Szum123321/weit_generator_v1/code/README.MD

Pliki kodu źródłowego znajdują się w folderze ./src. Plik konfiguracyjny w folderze ./include. W celu skompilowania pobierz i zainstaluj środowisko PlatformIO
