Szum123321/weit_generator_v1/docs/raport_techniczny.pdf

## Generator sygnału 1 kHz

Raport Techniczny

Szymon Januszek, szymon_j@tutanota.com

Kwiecień 2023

Streszczenie

Głównym celem poniższej konstrukcji jest otrzymanie sygnału możliwie najwyższej jakości, zdefiniowanych w założeniach konkursowych, tzn. dokładność częstotliwości, stopień zniekształceń harmonicznych oraz dokładność amplitudy sygnału.

## Spis treści

1 Bezpośrednia synteza cyfrowa | 3
2 Kształtowanie | 4
3 Kontrola Amplitudy | 5
4 Oprogramowanie | 7
5 Eksperymenty | 9

## 1 Bezpośrednia synteza cyfrowa

Aby wygenerować maksymalnie stabilny i dokładny względem częstotliwości sygnał, zdecydowałem się na wykorzystanie techniki Bezpośredniej Syntezy Cyfrowej, gdzie mikroprocesor wraz z układem Przetwornika Cyfrowo-Analogowego (DAC) generuje sygnał zbliżony do sygnału oczekiwanego. Umożliwia to zastosowanie wysokiej jakości generatora kwarcowego, jako głównego źródła odniesienia, o precyzji rzędu 50ppm¹
, w całym zakresie temperatur. Oznacza to, iż częstotliwość uzyskanego sygnału nie będzie odbiegać o więcej niż ±50 mHz od wartości oczekiwanej.

### 1.1 Mikrokontroler

Jako główny mikrokontroler wybrany został układ AVR32DA28[2] należący do rodziny 8-bitowych układów AVR. W porównaniu ze starszymi generacjami, producent dopuszcza pracę układu przy częstotliwościach przekraczających 8 MHz z napięciem 3 V. Jednocześnie dokonana została unifikacja modelu pamięci, co okaże być się przydatne przy pisaniu oprogramowania(4).

### 1.2 Przetwornik Cyfrowo-Analogowy

Do implementacji przetwornika zrealizowany został układ drabinki R-2R (Rys.1). Umożliwiając łatwą zmianę wartości liczbowej, przedstawionej jako liczba binarna na pinach mikrokontrolera, na ułamek napięcia zasilania.

2R

a0

R

an−1

2R | 2R

a1

R

an−2

2R

R

2R

a2

2R

Vout

Rysunek 1: Schemat drabiny R-2R [1]

Napięcie na węźle wyjściowym przetwornika można opisać w następujący sposób:

Vout = Vref ×

a0 × 2

0 + a1 × 2

1 + a2 × 2

2 + ... + aN−1 × 2

N−1
2

N
Jak widać, przy N = 8, przetwornik ten pozwala na uzyskanie 256 różnych wartości. Dla Vref = 3 V, oznacza to, iż różnica pomiędzy dwoma dowolnymi stopniami wynosi ok. 11.72 mV.
Co ciekawe, okazuje się, iż impedancja wyjściowa takiego układu jest stała dla każdego poziomu 2

1Części na milion
2Wynika to z Twierdzenie Thévenina, zakładającego zerową impedancję źródła oraz mikrokontrolera. W rzeczywistości ich wartości są znacznie mniejsze od wartości R.

Aby zachować użyteczność najniższych bitów, precyzja wykorzystanych rezystorów musi być lepsza niż 1
2N × 100% ≈ 0.3 %. Na szczęście, w sprzedaży dostępne są rezystory przeznaczone do montażu powierzchniowego o precyzji 0.1 %.

### 1.3 Analiza sygnału wyjściowego

Sygnał generowany w ten sposób nie opowiada jednak perfekcyjnej sinusoidzie (Rys. 2). Obecne jest tzw. zniekształcenie kwantyzacji, wynikające z faktu, iż sygnał złożony jest z serii dyskretnych wartości. Jednak jeśli dokładnie przyjrzymy się różnicy pomiędzy naszym sygnałem a idealnej sinusoidzie, to okaże się, że amplituda takiego sygnału jest nie wielka (∆V ←

Vref
2N ), a także składa się on z częstotliwości wielokrotnie większych niż częstotliwość fundamentalna generowanego sygnału.

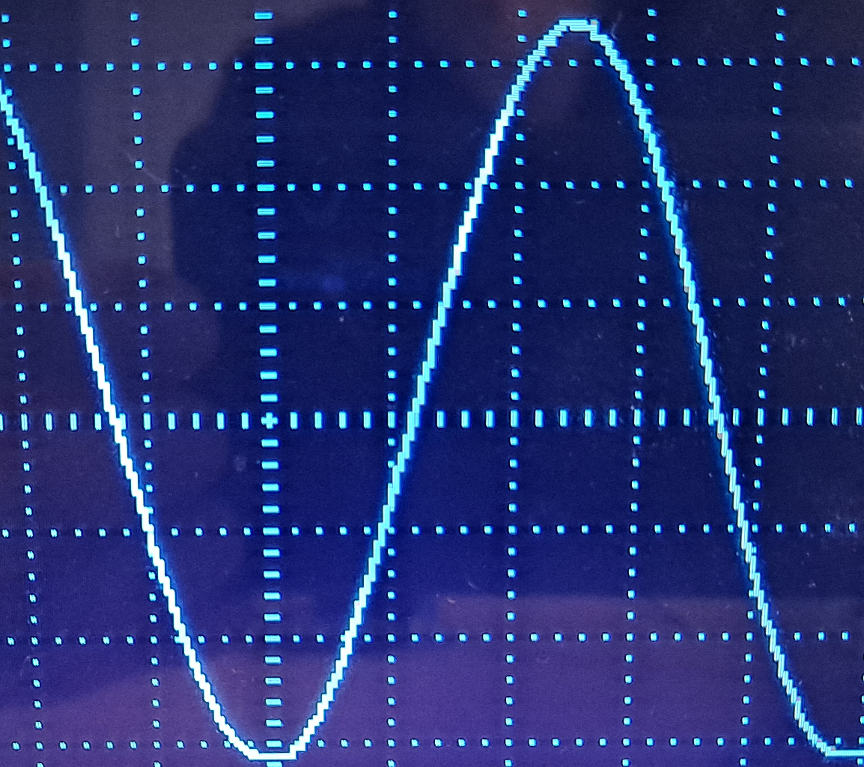
[picture p4: figure]

Rysunek 2: Przebieg sinusoidy generowanej przy pomocy przetwornika R-2R.

Możemy uznać, iż dobrym przybliżeniem takiego sygnału będzie suma sinusoidy o amplitudzie równej połowie napięcia zasilania Vref i o częstotliwości f0 oraz sygnału prostokątnego o częstotliwości f0×Nsmpl i amplitudzie 0.5×

Vref
2N , gdzie Nsmpl oznacza
ilość dyskretnych zmian napięcia w czasie jednego okresu.
Widzimy więc że że częstotliwość już częstotliwość drugiej składowej jest Nsmpl -krotnie większa, a jej amplituda 2

N−2π-krotnie mniejsza w porównaniu ze składową fundamentalną. Oznacza to, iż przy zastosowaniu filtru dolnoprzepustowego niskiego stopnia, możliwe jest efektywne usunięcie składowych wyższej częstotliwości.

## 2 Kształtowanie

Mimo wszystko należy usunąć składowe wyższej częstotliwości. Funkcje tą realizuje kondensator C2 (Rys. 3).
Dodatkowo, rzeczywiste wzmacniacze operacyjne nie są wstanie generować sygnałów bardzo bliskich < 300 mV szyn zasilania. Tłumienia tego dokonują C1, R1, R2, zachowując wartość środkową na poziomie 1.5 V

R1 100k

R2 100k

GND

5+
6-

7

U1B

+3V0
C1 10n

GND

C2 10n

IN | OUT

GND

+3V0

R1 100k

GND

R2 100k

Rysunek 3: Schemat filtru

## 3 Kontrola Amplitudy

Ostatnią zmienną którą należy rozpatrzyć jest amplituda sygnału wyjściowego. Na tym etapie amplituda sygnału jest większa od oczekiwanej wartości 0.5 V. Potrzebna jest więc metoda dokładnego tłumienia, nie wprowadzająca dodatkowych zniekształceń i zakłócenia.
Rozwiązanie oparte o nawet precyzyjny potencjometr pozostaje jednak wrażliwe na takie zmienne jak napięcie zasilania, czy też dryft parametrów elementów związany ze zmianą temperatury.
Tak więc, niezbędny jest układ aktywnie korygujący amplitudę sygnału. Cyfrowa implementacja takiego rozwiązania nie wchodzi w gre, ponieważ przetwornik DAC nie posiada wystarczającej głębokości bitowej. Stąd też, proponuję rozwiązanie w pełni analogowe.
Przy użyciu wzmacniaczy operacyjnych możemy uzyskać pętle sprzężenia zwrotnego, korygującą amplitude sygnału względem stałego napięcia odniesienia. Do realizacji tego rozwiązania potrzebujemy następujących elementów.

### 3.1 Pomiar amplitudy

Konieczny jest pomiar amplitudy sygnału wyjściowego. To tego celu służy tzw. Detektor szczytowy (Rys. 4).

R3 1M

R2 100

GND GND

C1 10n

R1 1M | D1 12+ | 1N6263

13-

14

U1D MCP6004

OUT IN

Peak detector

C1 10n

GND GND

R3 1M

Rysunek 4: Przykładowy schemat połówkowego detektora szczytowego

### 3.2 Element sprzęgający

Wymagany jest układ umożliwiający tłumienie sygnału zmiennego względem sygnału sterującego:

Vwyj ∝

Vwej

Vster

(1)

Fizyczna implementacja takiego układu okazuje się być niebanalna. Możliwy jest układ realizujący operacje mnożenia wartości sygnałów. Jego realizacja jednak jest wysoce złożona i wymaga relatywnie dużo części, ponieważ w jego skład wchodzą układy wyznaczające logarytm naturalny obu wartości, dodające te wartości do siebie, a na koniec wyznaczające funkcje wykładniczą e

x
tej sumy.
Alternatywna metoda wykorzystuje element zmieniający swój opór elektryczny względem jakiegoś innego czynnika. Przykładem historycznej realizacji takiego układu jest zastosowanie niewielkiej łapmy żarowej, której opór włókna jest wprost proporcjonalny do jego temperatury.
Istnieje jednak znacznie prostsze i wydajniejsze rozwiązanie.
Popularnym elementem o zmiennym oporze jest fotorezystor. W przeciwieństwie do innych elementów światłoczułych, przy stałym natężeniu światła, zachowuje się on jak faktyczny rezystor, tzn. prąd przepływający jest wprost proporcjonalny do napięcia i odwrotnie do jego oporu I ∝

V
Rφ
Tak więc, jeśli zamknie się fotorezystor w obudowie światłoszczelnej wraz z diodą LED, uzyskamy układ o zmiennym oporze elektrycznym, kontrolowany przez prąd diody³

R ∝

1

ILed

(2)

Umożliwia to łatwą implementacje układu sprzężenia (Eq. 1).
Co prawda powyższy model ignoruje fakt, iż tak na prawdę opór fotorezystora zależny jest wykładniczo od natężenia padającego światła R =
1
φ

A
. Nie stanowi jednak to dużego problemu ponieważ układ ten znajduje się w pętli sprzężenia zwrotnego.

R ∝

1

(ILed)

A

(3)

### 3.3 Źródło odniesienia

W tym momęcie potrzebne jest jedynie stabilne oraz dostrajalne źródło napięcia odniesienia. Do tego celu z zupełności wystarczy układ LM4041 wraz z precyzyjnym potencjometrem.

### 3.4 Dostrajanie

Szczególnie trudnym okazało się zapewnienie stabilnej pracy układu. Wartości elementów w pętli kompensacji zostały w większości dobrane empirycznie. Konieczne było zastosowanie dużej pojemności kondensatorów elektrolitycznych, ze względu na duży czas propagacji sygnału błędu przez tłumik, filtr oraz detektor.

3Zakładam φ ∝ I

## 4 Oprogramowanie

Czas przejść do opisu kodu źródłowego. W pliku sine_tab.cpp znajduje się definicja tabeli funkcji sinus. Składa się ona z 1024 próbek, a wartość i-tej próbki zdefiniowana jest w następujący sposób:

f(i) = (2N − 1) + $
(2N − 1) × sin

2π × i

Nsmpl !' | (4)

f(i) = 128 +

127 × sin

2π × i
1024 | (5)

Każda próbka jest 8-bitową liczbą całkowitą z zakresu ∈ {1 . . . 255}, jednocześnie tabela przedstawia cały jeden okres funkcji sinus, poza wartością sin(2π). Następną próbkę stanowi wartość sin(0). Dzięki temu reprodukowany sygnał nie zawiera przeskoku co cały okres.
Zadaniem oprogramowania mikrokontrolera pozostaje wczytanie kolejnych wartości z pamięci, a następnie ustawienie pinów na odpowiedni stan. Wykorzystując 8-bitową naturę architektury AVR możliwe jest ustawienie stanu całego rejestru (tj. grupy 8 pinów) poprzez pojedynczy zapis do obszaru peryferialnego pamięci (Linia 35)
W tym miejscu napotykamy jednak pewien problem, synteza powyższego sygnału wymaga produkcji ponad miliona próbek na sekundę, tym czasem zastosowany mikroprocesor jest przystosowany do pracy przy częstotliwości nie przekraczających 24 MHz. Przy zastosowanym generatorze kwarcowym o częstotliwości pracy 12.288 MHz oznacza to, że mamy dokładnie 12 cykli maszynowych na wygenerowanie następnej próbki, co więcej aby zachować precyzje częstotliwości musimy wykorzystać wszystkie 12 cykli za każdym razem. Stąd też decyzja o implementacji całego algorytmu bezpośrednio w niskopoziomowym assemblerze. Pozwala to na dokładną kontrolę nad czasem wykonania całego cyklu, a jednocześnie umożliwia szereg optymalizacji będących poza zasięgiem kompilatora.
Kolejne bajty pobierane są przez instrukcje ld (Linia 32), która jednocześnie inkrementuje wskaźnik tworzony przez parę rejestrów r30 i r31.
Problemem pozostaje jedynie wydajne zawijanie wskaźnika po dotarciu do 1024-tej wartości. Ponownie wykorzystując 8-bitową nature układów AVR, możliwe jest bardzo wydajne rozwiązanie tego problemu.
Jednym z atrybutów udostępnianych przez kompilator GCC jest __attribute__((aligned (1024))), który pozwala na wymuszenie wyrównania pozycji pierwszego bajtu danej zmiennej do wielokrotności liczby podanej jako argument. Oznacza to iż pozycja tablicy przyjmuje postać A × 1024.
Tak więc, niższy bajt 16-bitowego wskaźnika będzie ulegał stałym zmianą na całej swojej długości, natomiast w bajcie wyższym, dzięki wyrównaniu tabeli, zmieniać się będą jedynie dwa najniższe bity (Rys. 5).
Tak więc jedyne co tak na prawdę musimy robić to nie pozwolić na zmianę stanu 6 najwyższych bitów wskaźnika. Możemy to osiągnąć używając sprytnej sztuczki, zajmującej łącznie 2 cykle zegarowe (Linia 38).
r31′ = ((r31 ∧ 11bin) ∨ r20) | (6)

r31 | r30
SINE_TAB ≫ 10 | Licznik

Rysunek 5: Schemat rozkładu bitów we wskaźniku

Po pierwsze zerujemy sześć najwyższych bitów górnego rejestru instrukcją ANDI
- (And with Immidiate) z liczbą 3dec. Następnie instrukcja OR przywraca poprawny stan wyższych bitów, które na początku działania programu zostały zapisane w rejestrze 20 (Linijka 26).

### 4.1 Kod źródłowy

;© Szymon Januszek 2023
#include <avr/io.h>

#include "config.h"

.extern SINE_TAB
.global main

main:
;temporarly use r1 for ZERO
eor r1, r1

;select external clock as Main Clock source ldi r16, 0xD8; MAGIC VALUE
ldi r17, 0x83
out CPU_CCP, r16
sts CLKCTRL_MCLKCTRLA, r17; use external clock

out CPU_CCP, r16
sts CLKCTRL_MCLKCTRLB, r1; disable prescaler

;set port direction and clear
ldi r16, 0xFF
sts PORTD_DIRSET, r16
out PORT_OUT, r1

;load pointer to Z reg. pair ldi r20, hi8(SINE_TAB)
mov r31, r20
mov r30, r1

loop:
;pull next byte out of memory and increment the pointer ld r2, Z+

;output data
out PORT_OUT, r2

;cyclize data pointer
andi r31, 0x03
or r31, r20

;pad for 12.288 MHz
nop
nop
nop
nop

rjmp loop

## 5 Eksperymenty


Rysunek 6: złożony układ eksperymentalny

Przedstawiony układ został przetestowany z następującymi zmianami:

- Mikrokontroler: ATMega4809
- Rezystory drabiny R-2R: 10 kΩ, 20 kΩ

Układ ATMega4809 zachowuje pełną kompatybilność kodu źródłowego z AVR32DA28. Jednoczeście oba mikrokontrolery bazują na tej samej wersji architektury AVR. Zaobserwowane parametry pracy:

- Pobór prądu przy napięciu zasilania 3 V: 7 mA

## Źródła

[1] CC BY-SA 2.0. url: https://commons.wikimedia.org/wiki/File:R2rladder.png. (https://commons.wikimedia.org/wiki/File:R2r-ladder.png)
[2] Microchip corp. AVR32DA Final Data Sheet. url: https://ww1.microchip.com/downloads/aemDocuments/documents/MCU08/ProductDocuments/DataSheets/AVR32DA28-32-48-Data-Sheet-40002228B.pdf. (https://ww1.microchip.com/downloads/aemDocuments/documents/MCU08/ProductDocuments/DataSheets/AVR32DA28-32-48-Data-Sheet-40002228B.pdf)

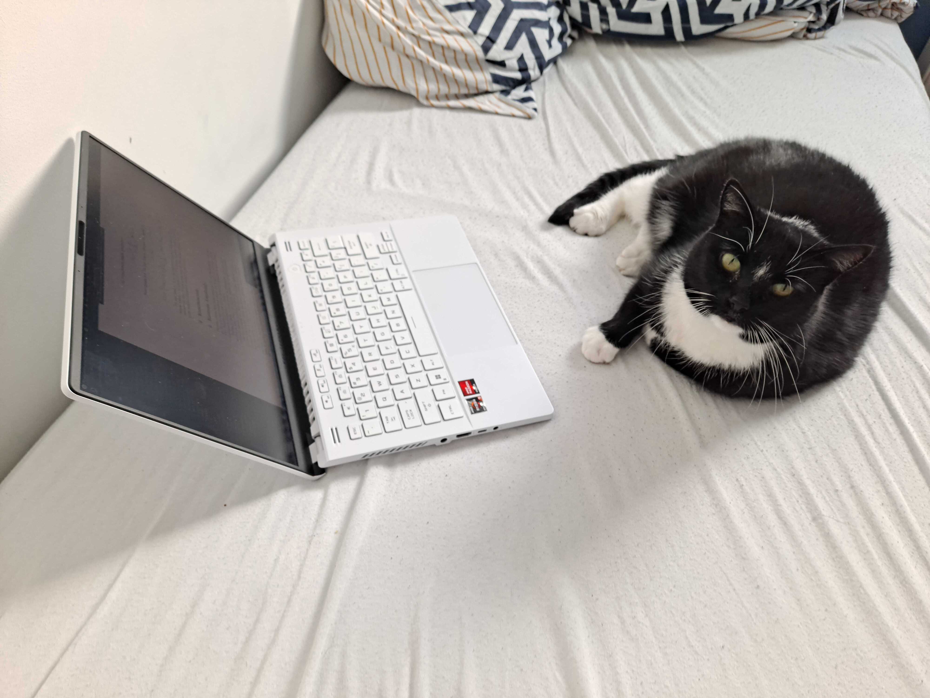
[picture p5: figure]

Rysunek 7: Kot autora wspomagający proces twórczy
