Szum123321/weit_generator_v1/bom.pdf

Ilość | Typ | Wartość | Cena za 1 szt. | Sumarycznie | Uwagi | URL
| 2 C | 100n | 0.45 PLN | | $0.90 Polipropylenowe
2 C | 100u | 0.00 PLN | 0.00 PLN Aluminiowe | Zasoby własne
3 C | 100n | 0.81 PLN | 2.43 PLN PET
1 C | 22u | 0.00 PLN | 0.00 PLN Aluminiowe | Zasoby własne
3 C | 10n | 2.59 PLN | 7.77 PLN Polipropylenowe
2 C | 1u | 1.57 PLN | 3.14 PLN Poliester
8 R | 1k | 0.61 PLN | 4.88 PLN 0.1% SMD
8 R | 2k | 0.67 PLN | 5.36 PLN 0.1% SMD
| 2 Rv | 10k | 1.76 PLN | 3.52 PLN
1 Q | 12.288MHz | 6.77 PLN | 6.77 PLN Generator Kwarcowy
| 1 D | 1n4148 | 0.00 PLN | 0.00 PLN | | Zasoby własne
1 U | AVR32DA28 | 8.27 PLN | 8.27 PLN MCU
1 U | MCP6004 | 4.24 PLN | 4.24 PLN OpAmp
1 U | LM4041C | 5.72 PLN | 5.72 PLN Vref
| 1 D | LED | 0.00 PLN | 0.00 PLN | | Własne zasoby
| 1 R | Fotorezystor | 0.00 PLN | 0.00 PLN | | Własne zasoby
| 1 Q | BC547 | 0.00 PLN | 0.00 PLN | | Własne zasoby
| 1 PCB | | 8.00 PLN | 8.00 PLN

Cena Sumaryczna
61.00 PLN

https://www.tme.eu/pl/details/jfz-100n_310-p10/kondensatory-foliowe-tht/jb-capacitors/

https://www.tme.eu/pl/details/b32529c1104j000/kondensatory-foliowe-tht/epcos/

https://www.tme.eu/pl/details/r75pf21004030j/kondensatory-foliowe-tht/kemet/https://www.tme.eu/pl/details/b32529c105k/kondensatory-foliowe-tht/epcos/b32529c0105k289/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

https://www.tme.eu/pl/details/avr32da28-i_so/rodzina-avr-8-bit/microchip-technology/https://www.tme.eu/pl/details/mcp6004-i_p/wzmacniacze-operacyjne-tht/microchip-te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

https://jlcpcb.com/
