Szum123321/weit_generator_v1/schemat.pdf

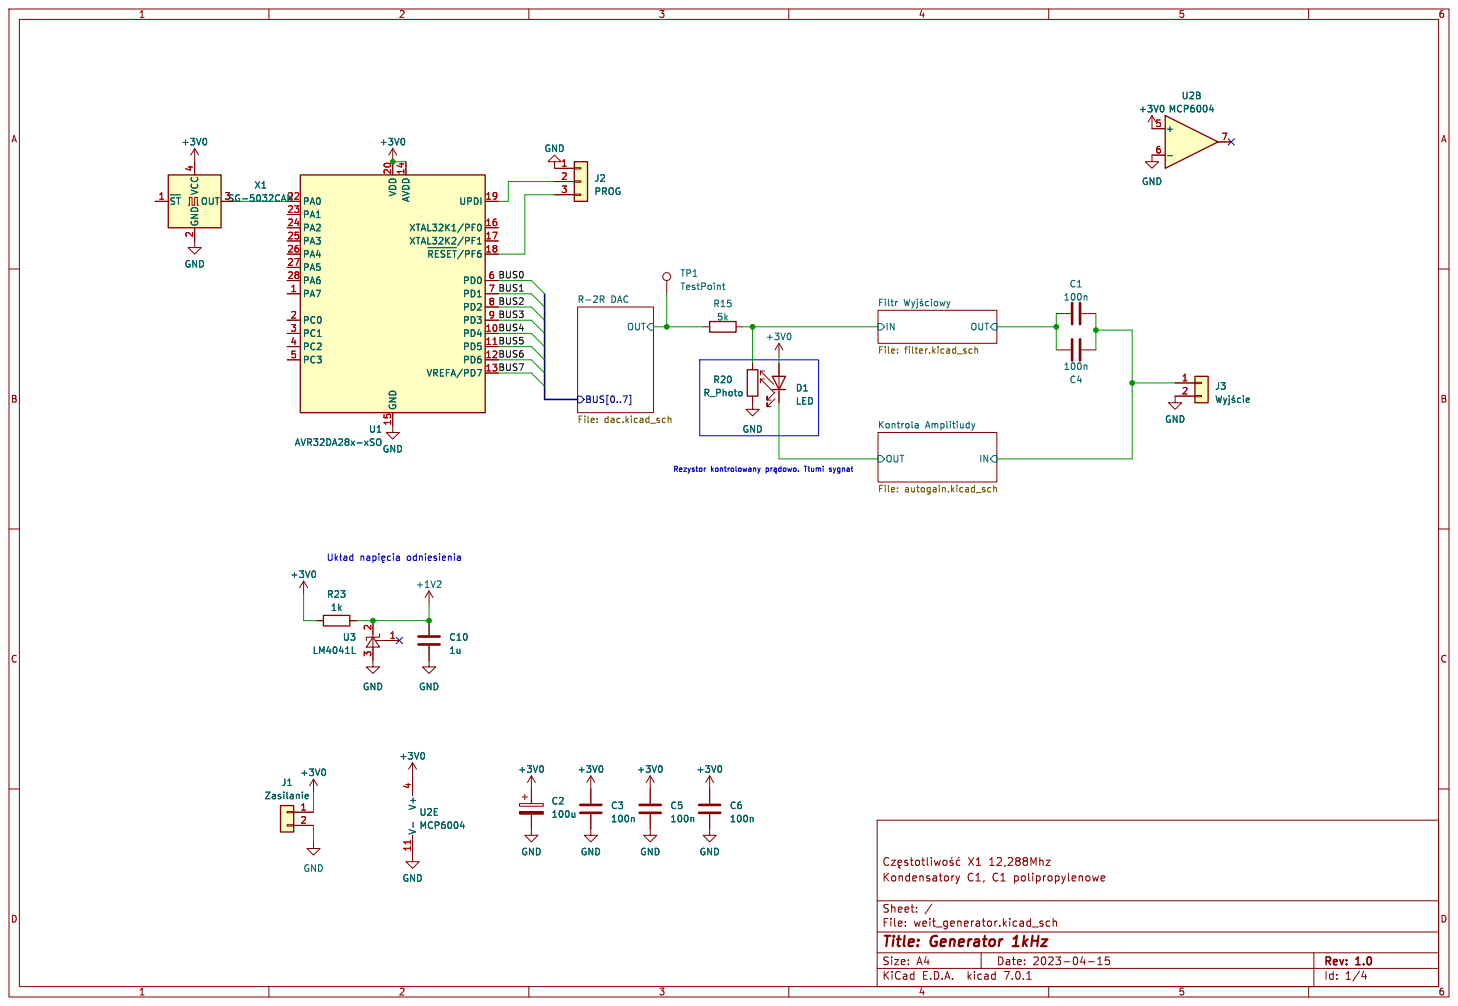
[picture p6: page 1]

Filtr þÿWyj[ciowy File: filter.kicad_sch OUT BUS[0..7] R-2R DAC

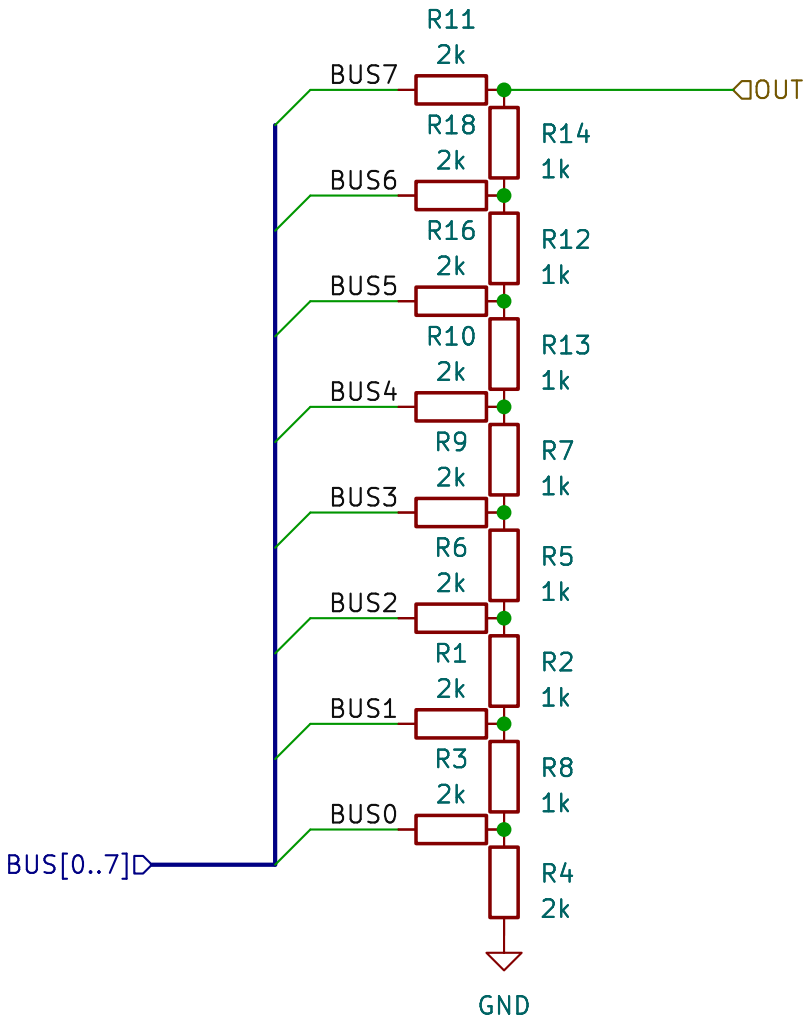
[picture p7: page 2]

Id: 2/4 Title: Przetwornik Cyfrowo-Analogowy

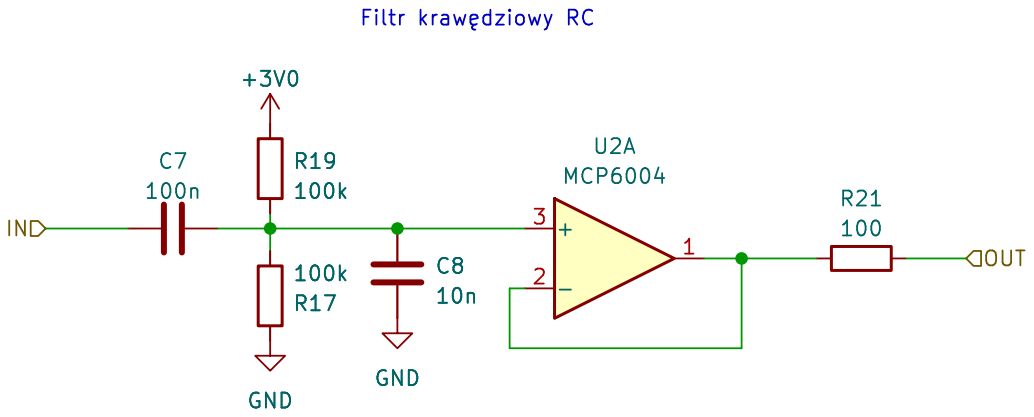
[picture p8: page 3]

Filtr þÿkrawdziowy RC GND

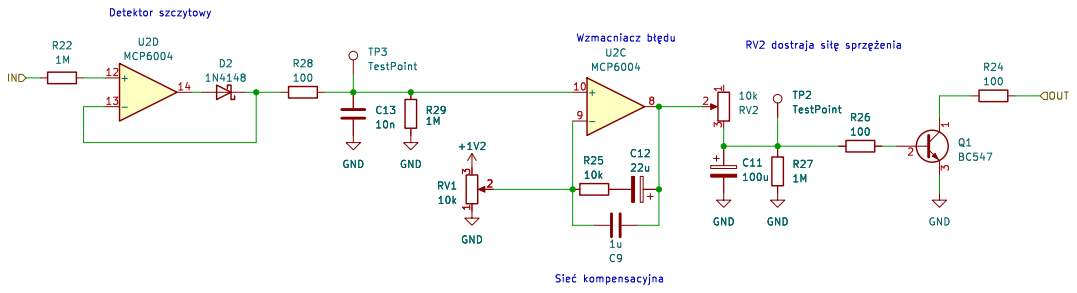
[picture p9: page 4]

Id: 4/4 Title: Automatyczna kontrola amplitudy
