Szum123321/weit_generator_v1/board/weit_generator/weit_generator.kicad_pcb

## KiCad design board/weit_generator/weit_generator.kicad_pcb (2023-04-15)

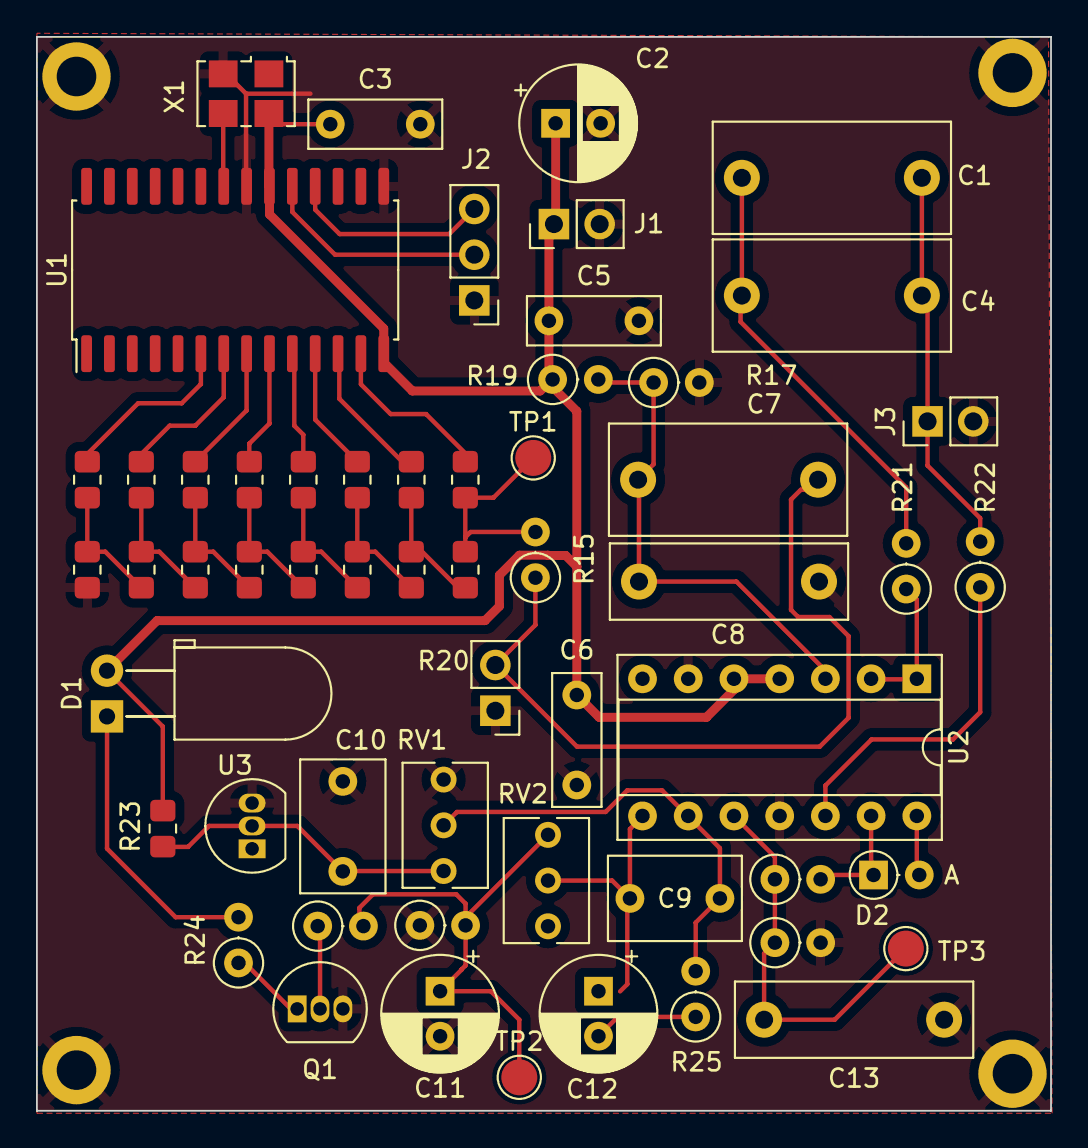
[picture p10: board weit_generator.kicad_pcb from above]

Board: 2 copper layers, 56.3 x 59.7 mm, 57 parts (0 on the bottom side), 38 nets.

Parts:
C1, C4, C7: 100n; C_Rect_L13.0mm_W6.0mm_P10.00mm_FKS3_FKP3_MKS4
C2, C11: 100u; CP_Radial_D6.3mm_P2.50mm
C3, C5, C6: 100n; C_Rect_L7.2mm_W2.5mm_P5.00mm_FKS2_FKP2_MKS2_MKP2
C8, C13: 10n; C_Rect_L13.0mm_W4.0mm_P10.00mm_FKS3_FKP3_MKS4
C9, C10: 1u; C_Rect_L7.2mm_W4.5mm_P5.00mm_FKS2_FKP2_MKS2_MKP2
C12: 22u; CP_Radial_D6.3mm_P2.50mm
D1: LED; LED_D5.0mm_Horizontal_O3.81mm_Z3.0mm
D2: 1N6263; D_DO-35_SOD27_P2.54mm_Vertical_AnodeUp
J1: Zasilanie; PinHeader_1x02_P2.54mm_Vertical
J2: PROG; PinHeader_1x03_P2.54mm_Vertical
J3: Wyjście; PinHeader_1x02_P2.54mm_Vertical
Q1: BC547; TO-92_Inline
R1, R3, R4, R6, R9, R10, R11, R16, R18: 2k; R_0805_2012Metric_Pad1.20x1.40mm_HandSolder
R2, R5, R7, R8, R12, R13, R14, R23: 1k; R_0805_2012Metric_Pad1.20x1.40mm_HandSolder
R15: 5k; R_Axial_DIN0207_L6.3mm_D2.5mm_P2.54mm_Vertical
R17, R19: 100k; R_Axial_DIN0207_L6.3mm_D2.5mm_P2.54mm_Vertical
R20: R_Photo; PinHeader_1x02_P2.54mm_Vertical
R21, R24, R26, R28: 100; R_Axial_DIN0207_L6.3mm_D2.5mm_P2.54mm_Vertical
R22, R27, R29: 1M; R_Axial_DIN0207_L6.3mm_D2.5mm_P2.54mm_Vertical
R25: 10k; R_Axial_DIN0207_L6.3mm_D2.5mm_P2.54mm_Vertical
RV1, RV2: 10k; Potentiometer_Bourns_3266Y_Vertical
TP1, TP2, TP3: TestPoint; TestPoint_Pad_D2.0mm
U1: AVR32DA28x-xSO; SOIC-28W_7.5x17.9mm_P1.27mm
U2: MCP6004; DIP-14_W7.62mm_Socket
U3: LM4041L; TO-92_Inline
X1: SG-5032CAN; Oscillator_SMD_SeikoEpson_SG8002LB-4Pin_5.0x3.2mm

Connections:
+1V2: C10.1, R23.2, RV1.3, U3.2 (K)
+3V0: C2.1, C3.1, C5.1, C6.1, D1.2 (A), J1.1, R19.1, R23.1, U1.14 (AVDD), U1.20 (VDD), U2.4 (V+), U2.5 (+), X1.4 (VCC)
/Filtr Wyjściowy/IN: C7.1, R15.1, R20.2
/Filtr Wyjściowy/OUT: C1.1, C4.1, R21.2
/Kontrola Amplitiudy/IN: C1.2, C4.2, J3.1, R22.2
/Kontrola Amplitiudy/OUT: D1.1 (K), R24.2
/R-2R DAC/BUS0: R3.1, U1.6 (PD0)
/R-2R DAC/BUS1: R1.1, U1.7 (PD1)
/R-2R DAC/BUS2: R6.1, U1.8 (PD2)
/R-2R DAC/BUS3: R9.1, U1.9 (PD3)
/R-2R DAC/BUS4: R10.1, U1.10 (PD4)
/R-2R DAC/BUS5: R16.1, U1.11 (PD5)
/R-2R DAC/BUS6: R18.1, U1.12 (PD6)
/R-2R DAC/BUS7: R11.1, U1.13 (VREFA/PD7)
/R-2R DAC/OUT: R11.2, R14.1, R15.2, TP1.1
GND: C2.2, C3.2, C5.2, C6.2, C8.1, C10.2, C11.2, C13.1, J1.2, J2.1, J3.2, Q1.3 (E), R4.2, R17.2, R20.1, R27.1, R29.2, RV1.1, U1.15 (GND), U1.21 (GND), U2.6 (-), U2.11 (V-), U3.3 (A), X1.2 (GND)
unnamed: C11.1, R26.2, R27.2, RV2.3, TP2.1
unnamed: C9.2, C12.1, RV2.2, U2.8
unnamed: C12.2, R25.1
unnamed: D2.2 (A), U2.14
unnamed: D2.1 (K), R28.2, U2.13 (-)
unnamed: J2.2, U1.19 (UPDI)
unnamed: J2.3, U1.18 (~RESET/PF6)
unnamed: Q1.2 (B), R26.1
unnamed: Q1.1 (C), R24.1
unnamed: R1.2, R2.2, R8.1
unnamed: R2.1, R5.2, R6.2
unnamed: R3.2, R4.1, R8.2
unnamed: R5.1, R7.2, R9.2
unnamed: R7.1, R10.2, R13.2
unnamed: R12.1, R14.2, R18.2
unnamed: R12.2, R13.1, R16.2
unnamed: U1.22 (PA0), X1.3 (OUT)
unnamed: C7.2, C8.2, R17.1, R19.2, U2.3 (+)
unnamed: R21.1, U2.1, U2.2 (-)
unnamed: C13.2, R28.1, R29.1, TP3.1, U2.10 (+)
unnamed: C9.1, R25.2, RV1.2, U2.9 (-)
unnamed: R22.1, U2.12 (+)
