Szum123321/weit_generator_v1/(commit log)

2023-04-13 added filtering
    [autogain.kicad_sch]
2023-04-14 hopefully repaired instability
    [autogain.kicad_sch, filter.kicad_sch, vref.kicad_sch, weit_generator.kicad_sch]
2023-04-14 New layout
    [autogain.kicad_sch, dac.kicad_sch, filter.kicad_sch, weit_generator.kicad_sch]
2023-04-15 finished board, added test desription and tuning to docs
    [autogain.kicad_sch, filter.kicad_sch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]
2023-04-15 WIELKA POLONIAAAAA
    [autogain.kicad_sch, bom.ods, dac.kicad_sch, filter.kicad_sch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]
2023-04-15 potężny polski assembler
    [autogain.kicad_sch, dac.kicad_sch, weit_generator.kicad_pcb]
2023-04-15 Final revision - submitting
    [autogain.kicad_sch, bom.ods, filter.kicad_sch, weit_generator.kicad_pcb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]
2023-04-15 Last minute poprawki
    [weit_generator-B_Cu.gbr, weit_generator-B_Mask.gbr, weit_generator-B_Paste.gbr, weit_generator-B_Silkscreen.gbr, weit_generator-Edge_Cuts.gbr, weit_generator-F_Cu.gbr, weit_generator-F_Mask.gbr, weit_generator-F_Paste.gbr]
